JoseVargasBeen/robot-mesero-esp32-modbus/(commit log)

2026-10-30 Robot mesero con ESP32 y Modbus TCP
    Firmware, registros Modbus, HMI, plano ISA 5.1 y datos de calibración
    del proyecto final de Ingeniería Mecatrónica.
2026-10-30 Añadir video de la entrega final narrado por el profesor
2026-10-30 Usar enlace público del video de la entrega final
2026-10-30 Resumen en ingles en el README
